loetlab-jena/xplorer/hw/xplorer_b.brd

## EAGLE design hw/xplorer_b.brd (2014-04-21)

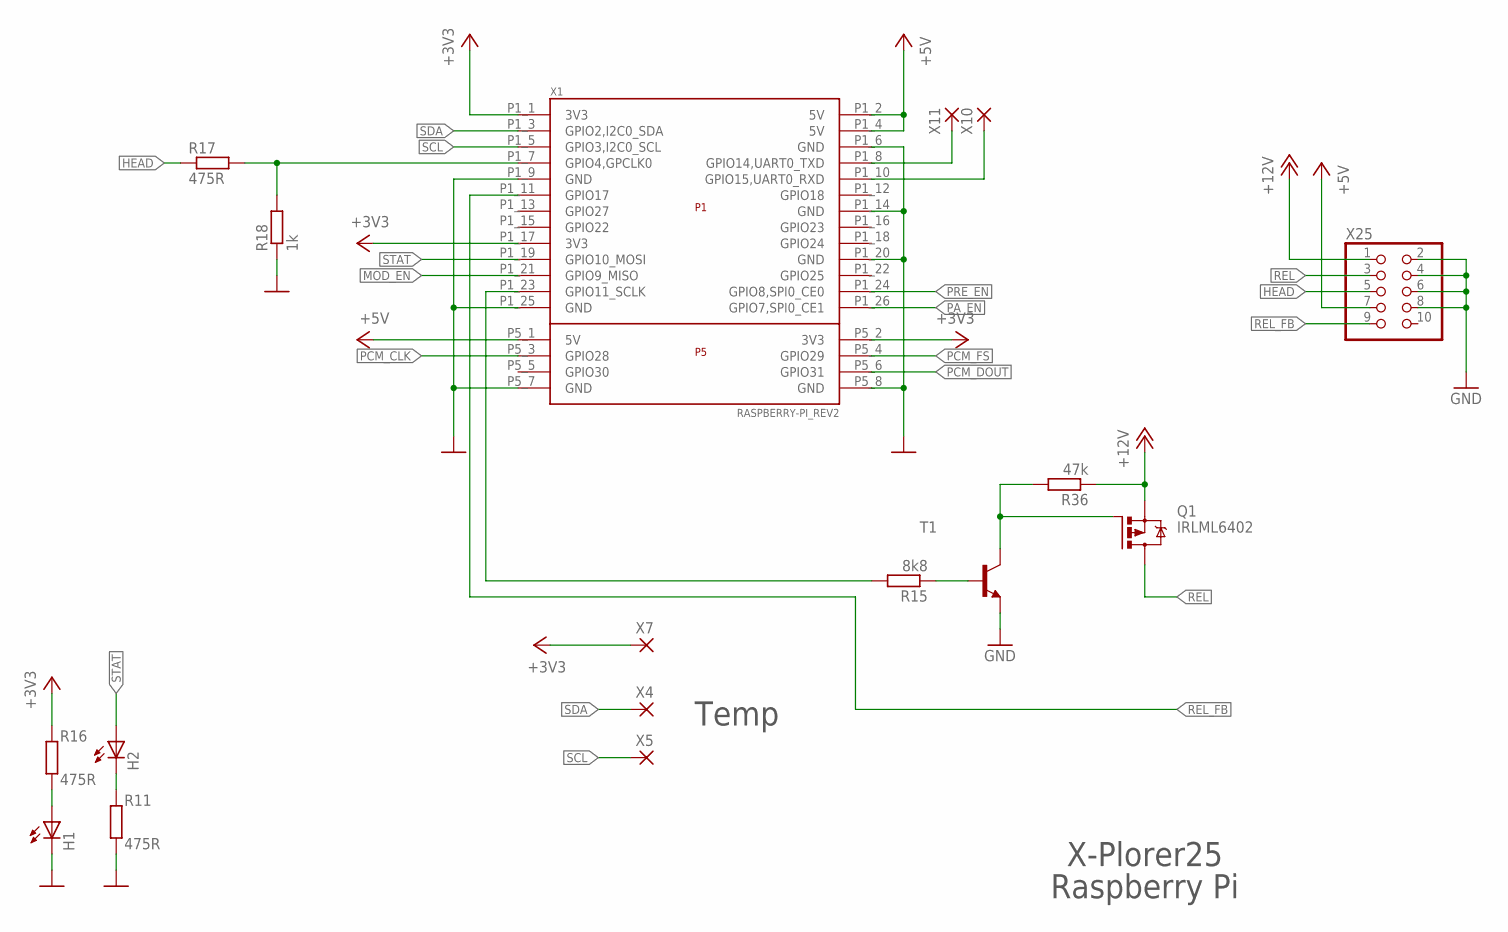
[picture p1: schematic xplorer_b.sch, sheet 1, RPI]

Parts:
H1, H2: PL006-WCR12; SOT23
Q1: IRLML6402; MICRO3
R11, R16, R17: 475R; R0603
R15: 8k8; R0603
R18: 1k; R0603
R36: 47k; R0603
T1: BC817-16-NPN-SOT23-BEC; SOT23-BEC
X1: RASPBERRY-PI_REV2
X4, X5, X7, X10, X11: SMD2; SMD1,27-2,54
X25: PINHD-2X5; 2X05

Connections:
+3V3: R16.2, X1.P1_1 (3V3), X1.P1_17 (3V3), X1.P5_2 (3V3), X7.1; also elsewhere on the board
+5V: X1.P1_2 (5V), X1.P1_4 (5V), X1.P5_1 (5V), X25.7; also elsewhere on the board
+12V: Q1.2 (S), R36.1, X25.1; also elsewhere on the board
GND: H1.3 (C), R11.1, R18.1, T1.E, X1.P1_6 (GND), X1.P1_9 (GND), X1.P1_14 (GND), X1.P1_20 (GND), X1.P1_25 (GND), X1.P5_7 (GND), X1.P5_8 (GND), X25.2, X25.4, X25.6, X25.8; also elsewhere on the board
HEAD: R17.1, X25.5
MOD_EN: X1.P1_21 (GPIO9_MISO); also elsewhere on the board
unnamed: H2.3 (C), R11.2
unnamed: H1.1 (A), R16.1
unnamed: R17.2, R18.2, X1.P1_7 (GPIO4,GPCLK0)
unnamed: X1.P1_10 (GPIO15,UART0_RXD), X10.1
unnamed: R15.1, T1.B
unnamed: Q1.1 (G), R36.2, T1.C
unnamed: X1.P1_8 (GPIO14,UART0_TXD), X11.1
unnamed: R15.2, X1.P1_23 (GPIO11_SCLK)
PA_EN: X1.P1_26 (GPIO7,SPI0_CE1); also elsewhere on the board
PCM_CLK: X1.P5_3 (GPIO28); also elsewhere on the board
PCM_DOUT: X1.P5_6 (GPIO31); also elsewhere on the board
PCM_FS: X1.P5_4 (GPIO29); also elsewhere on the board
PRE_EN: X1.P1_24 (GPIO8,SPI0_CE0); also elsewhere on the board
REL: Q1.3 (D), X25.3
REL_FB: X1.P1_11 (GPIO17), X25.9
SCL: X1.P1_5 (GPIO3,I2C0_SCL), X5.1; also elsewhere on the board
SDA: X1.P1_3 (GPIO2,I2C0_SDA), X4.1; also elsewhere on the board
STAT: H2.1 (A), X1.P1_19 (GPIO10_MOSI)

Notes on the sheet:
X-Plorer25
Raspberry Pi
Temp

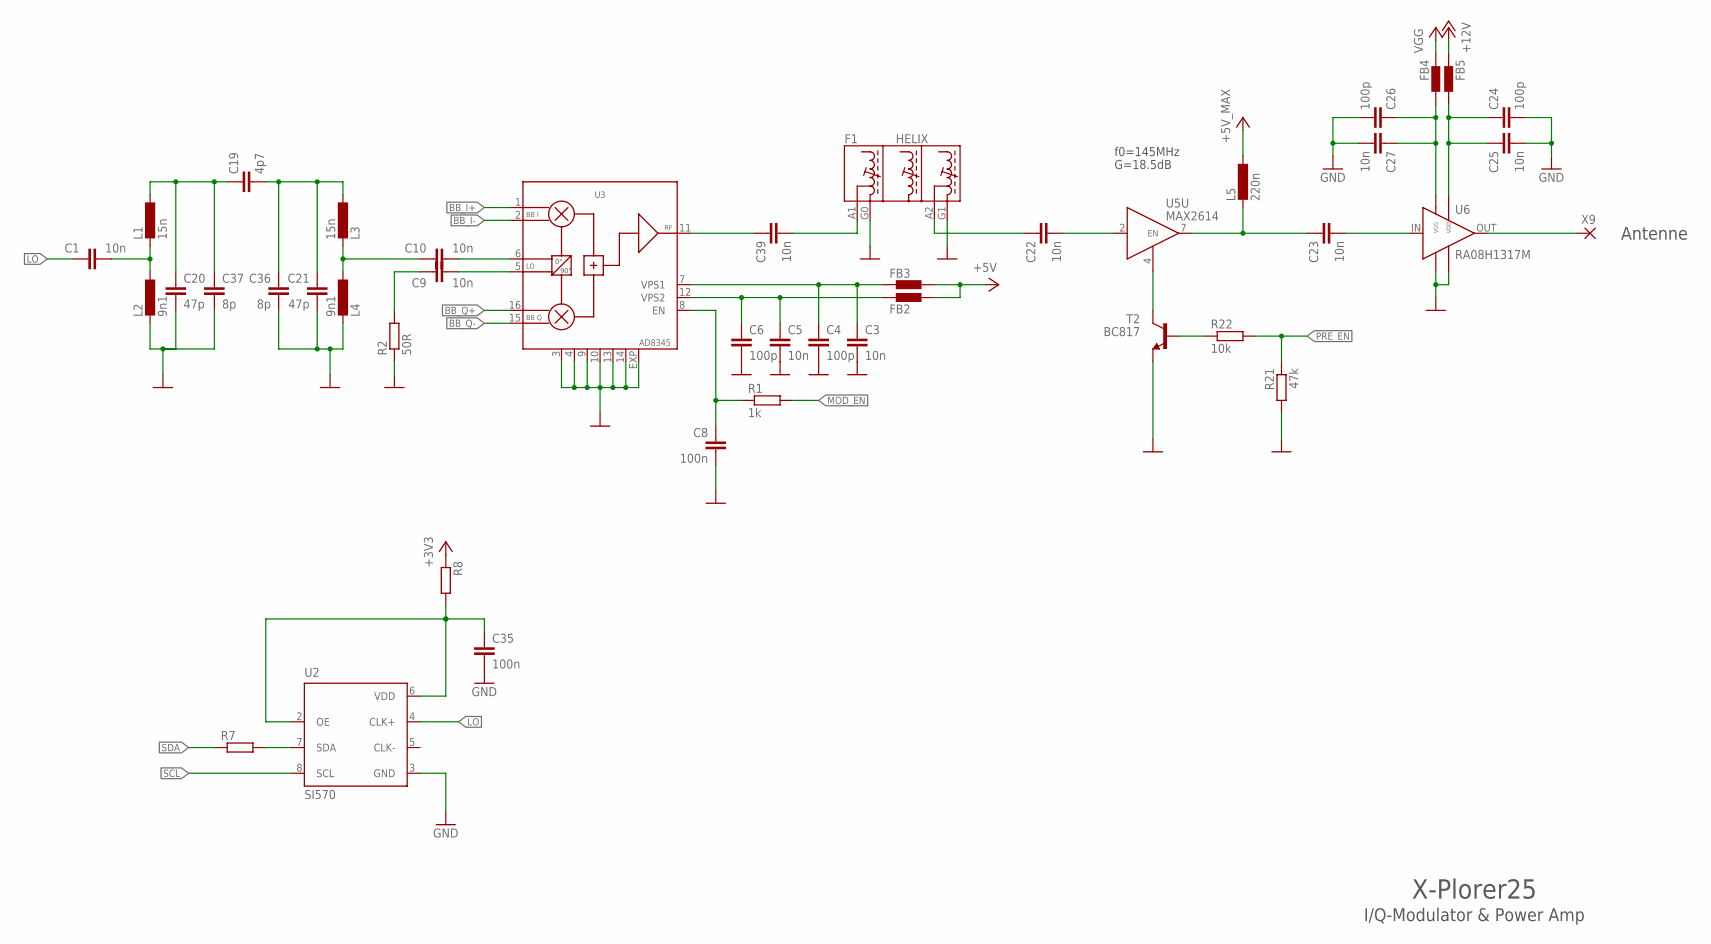
[picture p2: schematic xplorer_b.sch, sheet 2, IQ]

Parts:
C1, C3, C5, C9, C10, C22, C23, C25, C27, C39: 10n; C0603
C4, C6, C24, C26: 100p; C0603
C8: 100n; C0603
C19: 4p7; C0603
C20, C21: 47p; C0805K
C35: 100n; 0603
C36, C37: 8p; C0805K
F1: HELIX; CBT13
FB2, FB3, FB4, FB5: BML15H; R0603
L1, L3: 15n; L2012C
L2, L4: 9n1; L2012C
L5: 220n; L2012C
R1: 1k; R0603
R2: 50R; R0603
R7: R-EU_R0603; R0603
R8: R-EU_R2010; R2010
R21: 47k; R0603
R22: 10k; R0603
T2: BC817; SOT23-BEC
U2: SI570; 8-PIN
U3: AD8345; TSSOP16EXP
U5: MAX2614; TDFN8-2X3MM
U6: RA08H1317M
X9: SMD2; SMD1,27-2,54

Connections:
+3V3: R8.1; also elsewhere on the board
+5V: FB2.2, FB3.2; also elsewhere on the board
+5V_MAX: L5.1; also elsewhere on the board
+12V: FB5.1; also elsewhere on the board
BB_I+: U3.1 (BB_I); also elsewhere on the board
BB_I-: U3.2 (!BB_I); also elsewhere on the board
BB_Q+: U3.16 (BB_Q); also elsewhere on the board
BB_Q-: U3.15 (!BB_Q); also elsewhere on the board
CLEAN_LO: C10.1, L3.2, L4.1
GND: C3.2, C4.2, C5.2, C6.2, C8.2, C20.2, C21.2, C24.2, C25.2, C26.2, C27.2, C35.2, C36.2, C37.2, F1.G0 (GND), F1.G1 (GND), L2.2, L4.2, R2.1, R21.2, T2.E, U2.3 (GND), U3.3 (GND), U3.4 (GND), U3.9 (GND), U3.10 (GND), U3.13 (GND), U3.14 (GND), U3.EXP (GND), U6.G1 (GND), U6.G2 (GND); also elsewhere on the board
LO: C1.1, U2.4 (CLK+)
MOD_EN: R1.2; also elsewhere on the board
unnamed: C39.2, F1.A1
unnamed: C10.2, U3.6 (LO)
unnamed: C3.1, C4.1, FB3.1, U3.7 (VPS1)
unnamed: C5.1, C6.1, FB2.1, U3.12 (VPS2)
unnamed: C8.1, R1.1, U3.8 (EN)
unnamed: C9.2, U3.5 (!LO)
unnamed: C9.1, R2.2
unnamed: C39.1, U3.11 (RF)
unnamed: R7.2, U2.7 (SDA)
unnamed: C19.2, C21.1, C36.1, L3.1
unnamed: C22.1, F1.A2
unnamed: C1.2, L1.2, L2.1
unnamed: C35.1, R8.2, U2.2 (OE), U2.6 (VDD)
unnamed: C22.2, U5.2 (IN)
unnamed: C23.1, L5.2, U5.7 (OUT)
unnamed: C23.2, U6.IN
unnamed: C24.1, C25.1, FB5.2, U6.VDD
unnamed: C26.1, C27.1, FB4.2, U6.VGG
unnamed: U6.OUT, X9.1
unnamed: T2.C, U5.4 (EN)
unnamed: R22.1, T2.B
PRE_EN: R21.1, R22.2; also elsewhere on the board
SCL: U2.8 (SCL); also elsewhere on the board
SDA: R7.1; also elsewhere on the board
VGG: FB4.1; also elsewhere on the board
VLA: C19.1, C20.1, C37.1, L1.1

Notes on the sheet:
X-Plorer25
I/Q-Modulator & Power Amp
f0=145MHz
G=18.5dB
Antenne

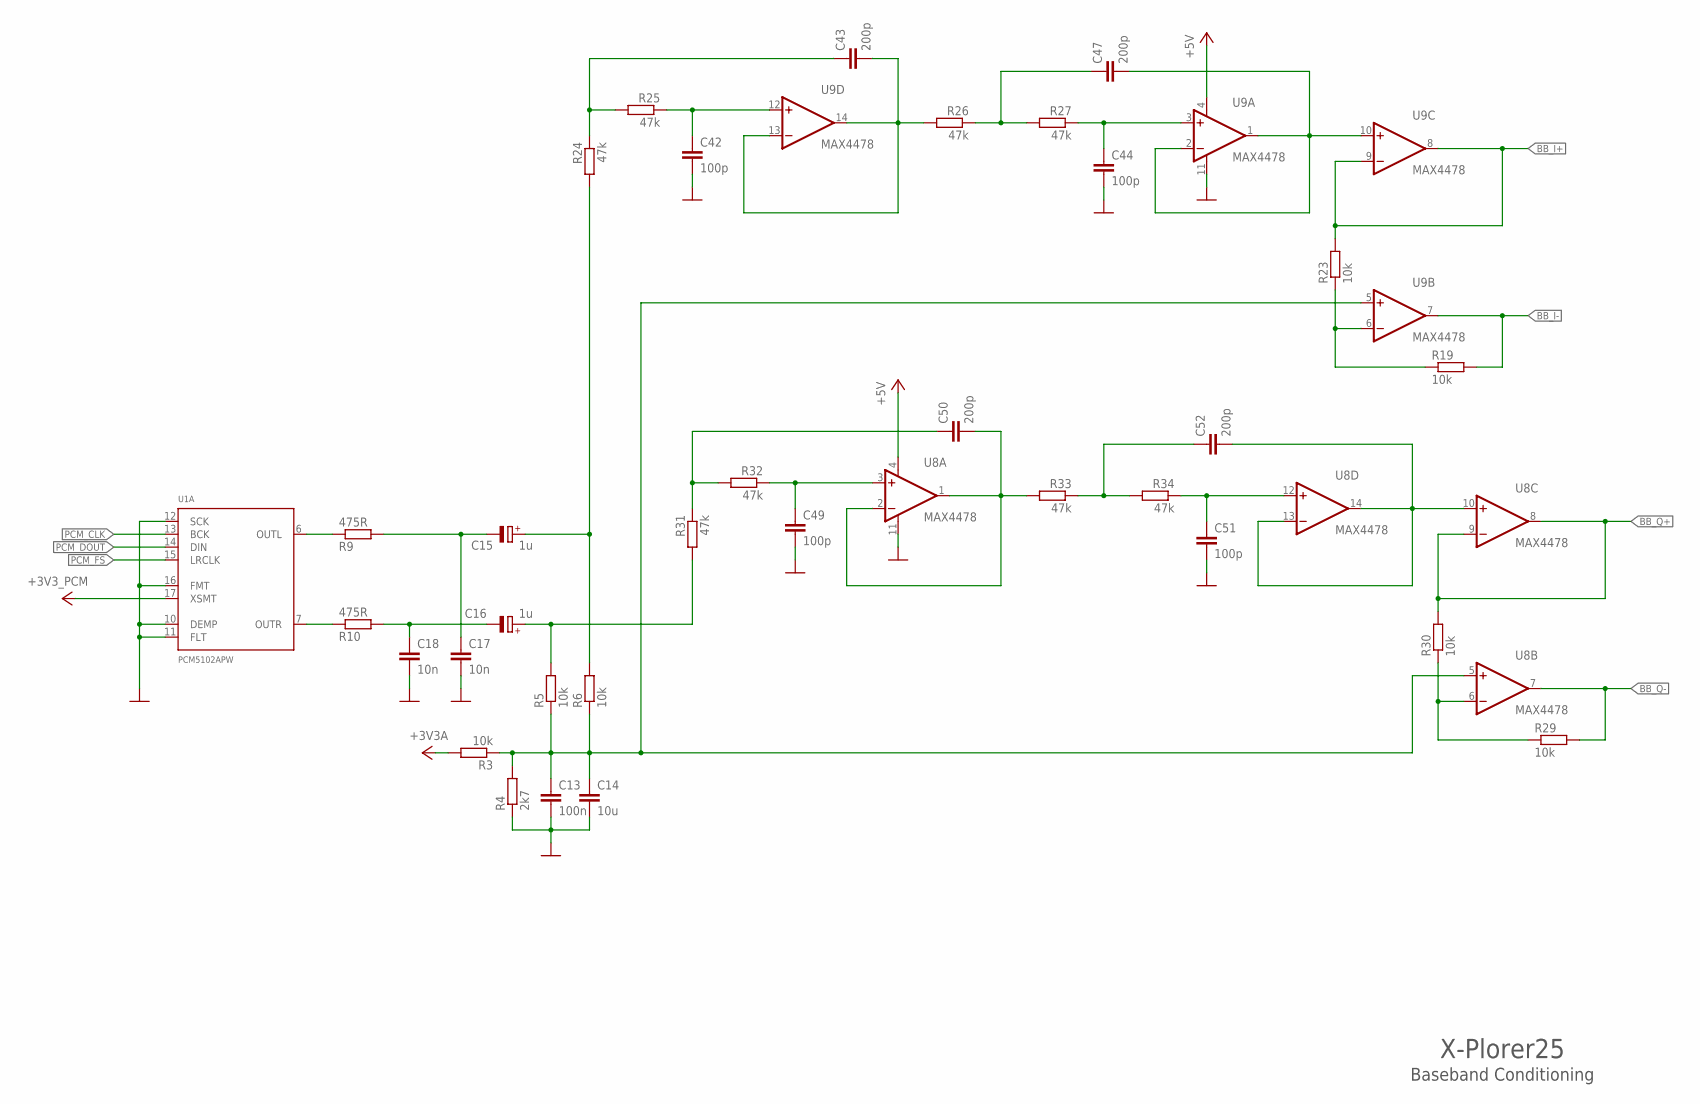
[picture p3: schematic xplorer_b.sch, sheet 3, BB]

Parts:
C13: 100n; C0603
C14: 10u; C0603
C15, C16: 1u; CT3528
C17, C18: 10n; C0603
C42, C44, C49, C51: 100p; C0603
C43, C47, C50, C52: 200p; C0805
R3, R5, R6, R19, R23, R29, R30: 10k; R0603
R4: 2k7; R0603
R9, R10: 475R; R0603
R24, R25, R26, R27, R31, R32, R33, R34: 47k; R0603
U1: PCM5102APW; PW_R-PDSO-G20
U8: MAX4478; SO14; MPN OPA4132UA
U9: MAX4478; SO14

Connections:
$2345: C16.+, R5.2, R31.2
$123456: C15.+, R6.2, R24.2
+3V3A: R3.2; also elsewhere on the board
+3V3_PCM: U1.17 (XSMT); also elsewhere on the board
+5V: U8.4 (V+), U9.4 (V+); also elsewhere on the board
BB_I+: R23.2, U9.8 (OUT), U9.9 (-IN); also elsewhere on the board
BB_I-: R19.2, U9.7 (OUT); also elsewhere on the board
BB_Q+: R30.2, U8.8 (OUT), U8.9 (-IN); also elsewhere on the board
BB_Q-: R29.2, U8.7 (OUT); also elsewhere on the board
GND: C13.2, C14.2, C17.2, C18.2, C42.2, C44.2, C49.2, C51.2, R4.1, U1.10 (DEMP), U1.11 (FLT), U1.12 (SCK), U1.16 (FMT), U8.11 (V-), U9.11 (V-); also elsewhere on the board
unnamed: C49.1, R32.1, U8.3 (+IN)
unnamed: R10.1, U1.7 (OUTR)
unnamed: C16.-, C18.1, R10.2
unnamed: R9.1, U1.6 (OUTL)
unnamed: C50.1, R31.1, R32.2
unnamed: C52.2, U8.10 (+IN), U8.13 (-IN), U8.14 (OUT)
unnamed: C51.1, R34.1, U8.12 (+IN)
unnamed: C52.1, R33.1, R34.2
unnamed: C42.1, R25.1, U9.12 (+IN)
unnamed: C43.1, R24.1, R25.2
unnamed: C47.2, U9.1 (OUT), U9.2 (-IN), U9.10 (+IN)
unnamed: C44.1, R27.1, U9.3 (+IN)
unnamed: C47.1, R26.1, R27.2
unnamed: C43.2, R26.2, U9.13 (-IN), U9.14 (OUT)
unnamed: C50.2, R33.2, U8.1 (OUT), U8.2 (-IN)
unnamed: R19.1, R23.1, U9.6 (-IN)
unnamed: R29.1, R30.1, U8.6 (-IN)
unnamed: C15.-, C17.1, R9.2
PCM_CLK: U1.13 (BCK); also elsewhere on the board
PCM_DOUT: U1.14 (DIN); also elsewhere on the board
PCM_FS: U1.15 (LRCLK); also elsewhere on the board
VGND: C13.1, C14.1, R3.1, R4.2, R5.1, R6.1, U8.5 (+IN), U9.5 (+IN)

Notes on the sheet:
X-Plorer25
Baseband Conditioning

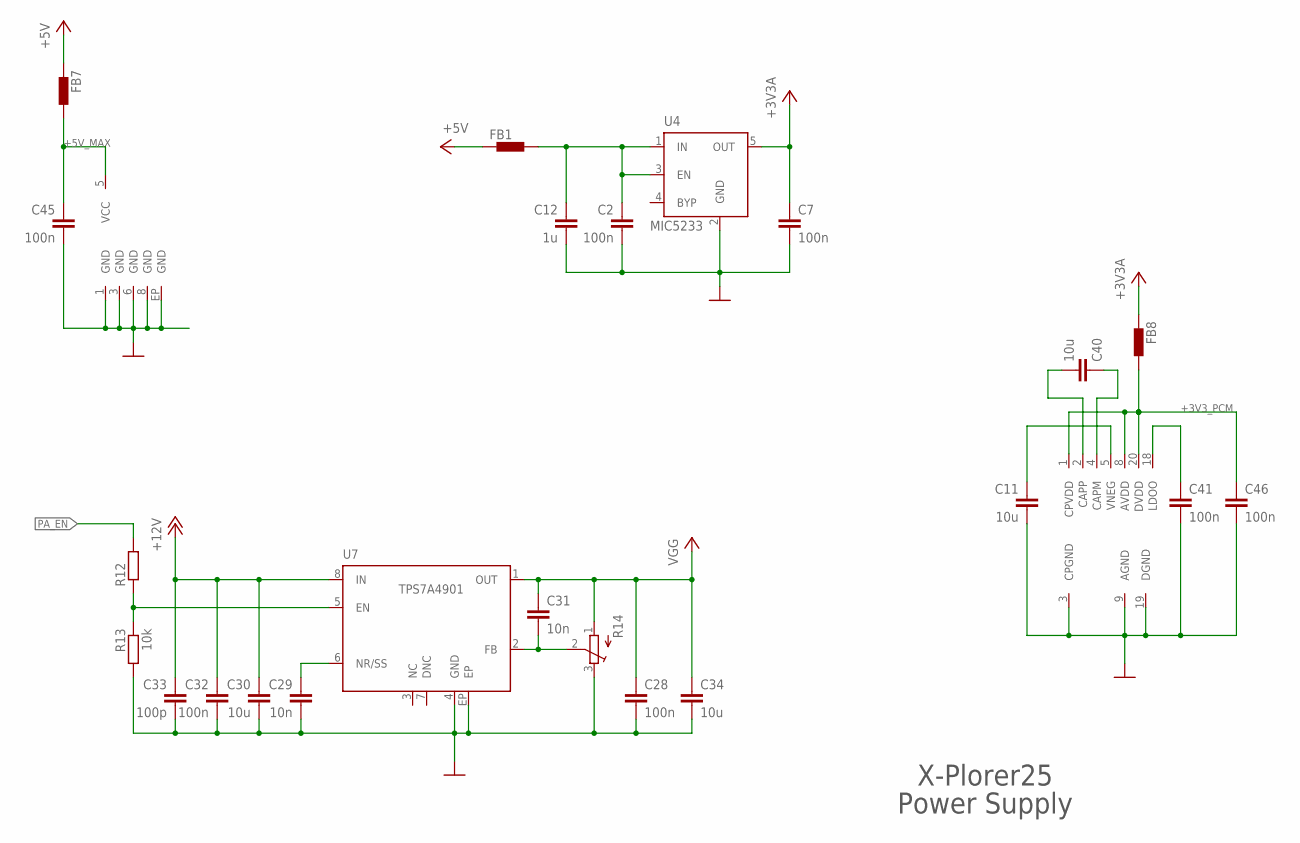
[picture p4: schematic xplorer_b.sch, sheet 4, PWR]

Parts:
C2, C7, C28, C32, C41, C45, C46: 100n; C0603
C11, C30, C34, C40: 10u; C0805
C12: 1u; C0603
C29: 10n; C0603K
C31: 10n; C0603
C33: 100p; C0603
FB1, FB7, FB8: BML15H; R0603
R12: R-EU_R0603; R0603
R13: 10k; R0603
R14: TRIM_EU-SM-42/43X; SM-42/43X
U1: PCM5102APW; PW_R-PDSO-G20
U4: MIC5233; SOT23-5
U5: MAX2614; TDFN8-2X3MM
U7: TPS7A4901; PW_R-PDSO-G08

Connections:
12V_F: C2.1, C12.1, FB1.2, U4.1 (IN), U4.3 (EN)
+3V3A: C7.1, FB8.1, U4.5 (OUT); also elsewhere on the board
+3V3_PCM: C46.1, FB8.2, U1.1 (CPVDD), U1.8 (AVDD), U1.20 (DVDD); also elsewhere on the board
+5V: FB1.1, FB7.1; also elsewhere on the board
+5V_MAX: C45.1, FB7.2, U5.5 (VCC); also elsewhere on the board
+12V: C30.1, C32.1, C33.1, U7.8 (IN); also elsewhere on the board
GND: C2.2, C7.2, C11.2, C12.2, C28.2, C29.2, C30.2, C32.2, C33.2, C34.2, C41.2, C45.2, C46.2, R13.2, R14.3 (E), U1.3 (CPGND), U1.9 (AGND), U1.19 (DGND), U4.2 (GND), U5.1 (GND), U5.3 (GND), U5.6 (GND), U5.8 (GND), U5.EP (GND), U7.4 (GND), U7.EP; also elsewhere on the board
unnamed: R12.1, R13.1, U7.5 (EN)
unnamed: C31.2, R14.2 (S), U7.2 (FB)
unnamed: C11.1, U1.5 (VNEG)
unnamed: C40.1, U1.4 (CAPM)
unnamed: C40.2, U1.2 (CAPP)
unnamed: C41.1, U1.18 (LDOO)
unnamed: C29.1, U7.6 (NR/SS)
PA_EN: R12.2; also elsewhere on the board
VGG: C28.1, C31.1, C34.1, R14.1 (A), U7.1 (OUT); also elsewhere on the board

Notes on the sheet:
X-Plorer25
Power Supply

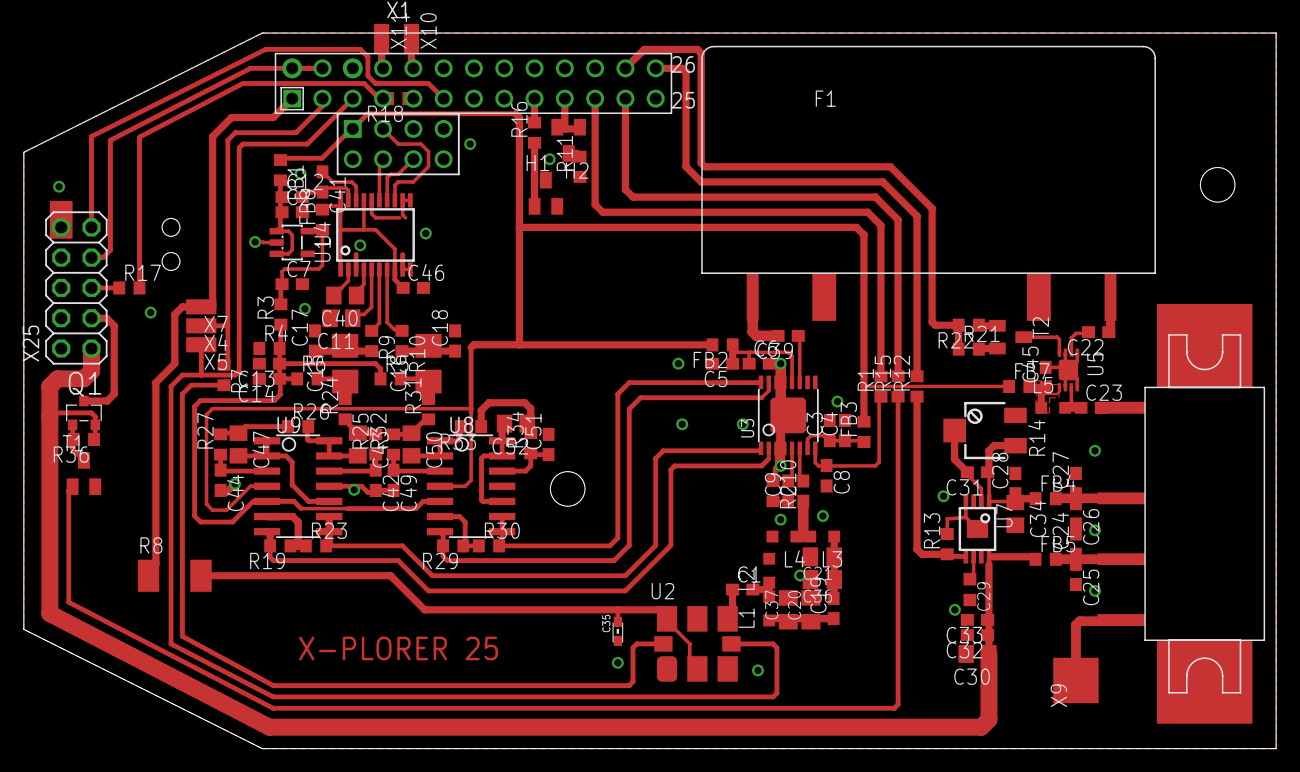
[picture p5: board xplorer_b.brd from above]

Board: 2 copper layers, 105.0 x 60.0 mm, 118 parts (0 on the bottom side), 85 nets.
