loetlab-jena/xplorer/hw/xplorer_t.brd

## EAGLE design hw/xplorer_t.brd (2014-04-24)

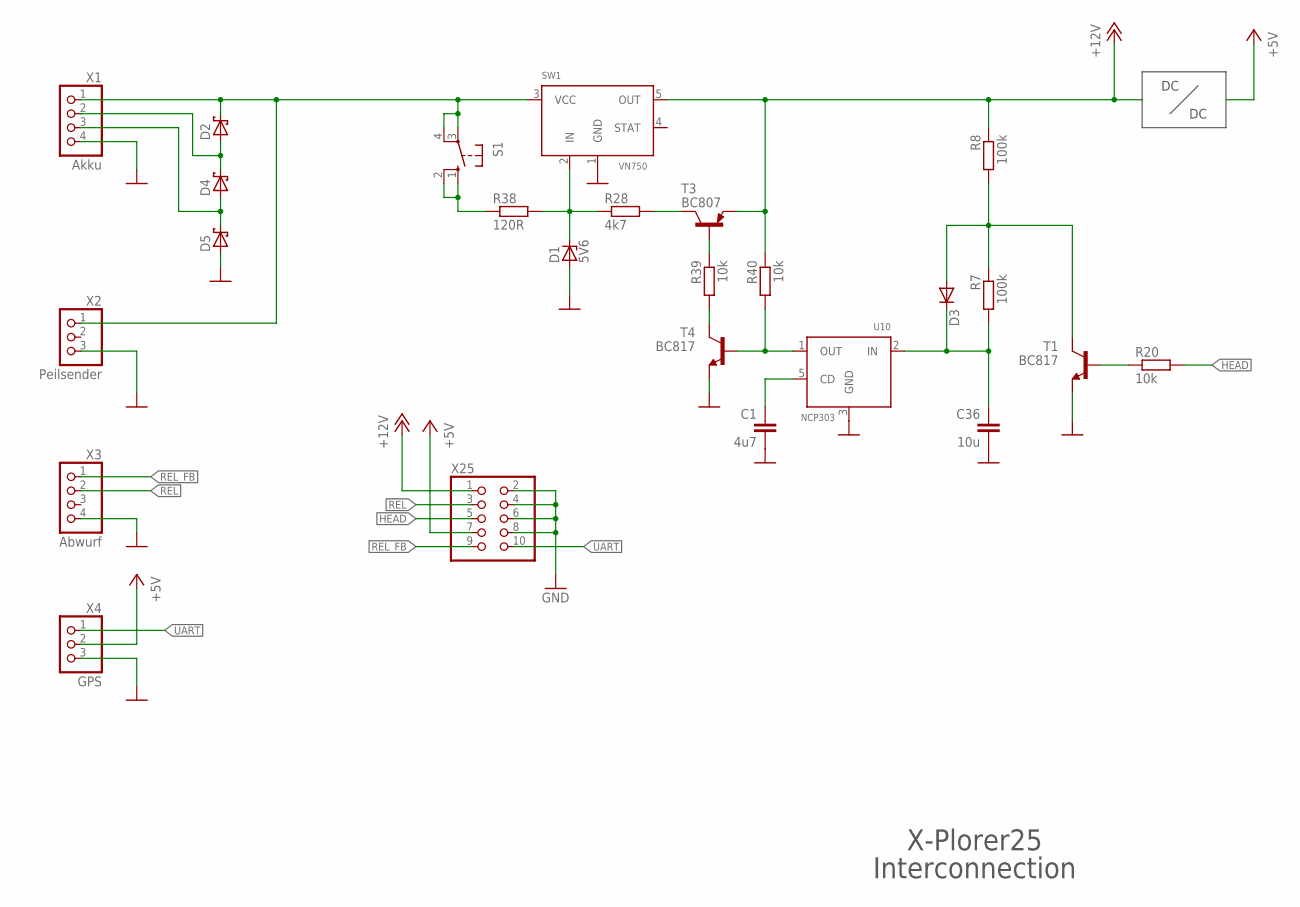
[picture p6: schematic xplorer_t.sch, RPI]

Parts:
C1: 4u7; C1210
C36: 10u; C1210
D1: 5V6; SOT23
D2, D4, D5: MBRS130LT3; SMB
D3: DIODE-MINIMELF; MINIMELF
R7, R8: 100k; R0805
R20, R39, R40: 10k; R0805
R28: 4k7; R0805
R38: 120R; R1206
S1: 10-XX; B3F-10XX
SW1: VN750; DDPAK
T1, T4: BC817; SOT23-BEC
T3: BC807; SOT23-BEC
U10: NCP303; SOT23-DBV
X1: Akku; 1X04
X2: Peilsender; 1X03/90
X3: Abwurf; 1X04/90
X4: GPS; 1X03
X25: PINHD-2X5; 2X05

Connections:
+5V: X4.2, X25.7
+12V: R8.1, R40.1, SW1.5 (OUT), T3.E, X25.1
GND: C1.2, C36.2, D1.1 (A), D5.A, SW1.1 (GND), T1.E, T4.E, U10.3 (GND), X1.4, X2.3, X3.4, X4.3, X25.2, X25.4, X25.6, X25.8
HEAD: R20.2, X25.5
unnamed: C1.1, U10.5 (CD)
unnamed: D2.A, D4.C, X1.2
unnamed: D4.A, D5.C, X1.3
unnamed: R38.1, S1.1 (S), S1.2 (S1)
unnamed: C36.1, D3.C, R7.2, U10.2 (IN)
unnamed: D2.C, S1.3, S1.4 (P1), SW1.3 (VCC), X1.1, X2.1
unnamed: D1.3 (C), R28.1, R38.2, SW1.2 (IN)
unnamed: D3.A, R7.1, R8.2, T1.C
unnamed: R28.2, T3.C
unnamed: R20.1, T1.B
unnamed: R39.2, T4.C
unnamed: R39.1, T3.B
unnamed: R40.2, T4.B, U10.1 (OUT)
REL: X3.2, X25.3
REL_FB: X3.1, X25.9
UART: X4.1, X25.10

Notes on the sheet:
X-Plorer25
Interconnection

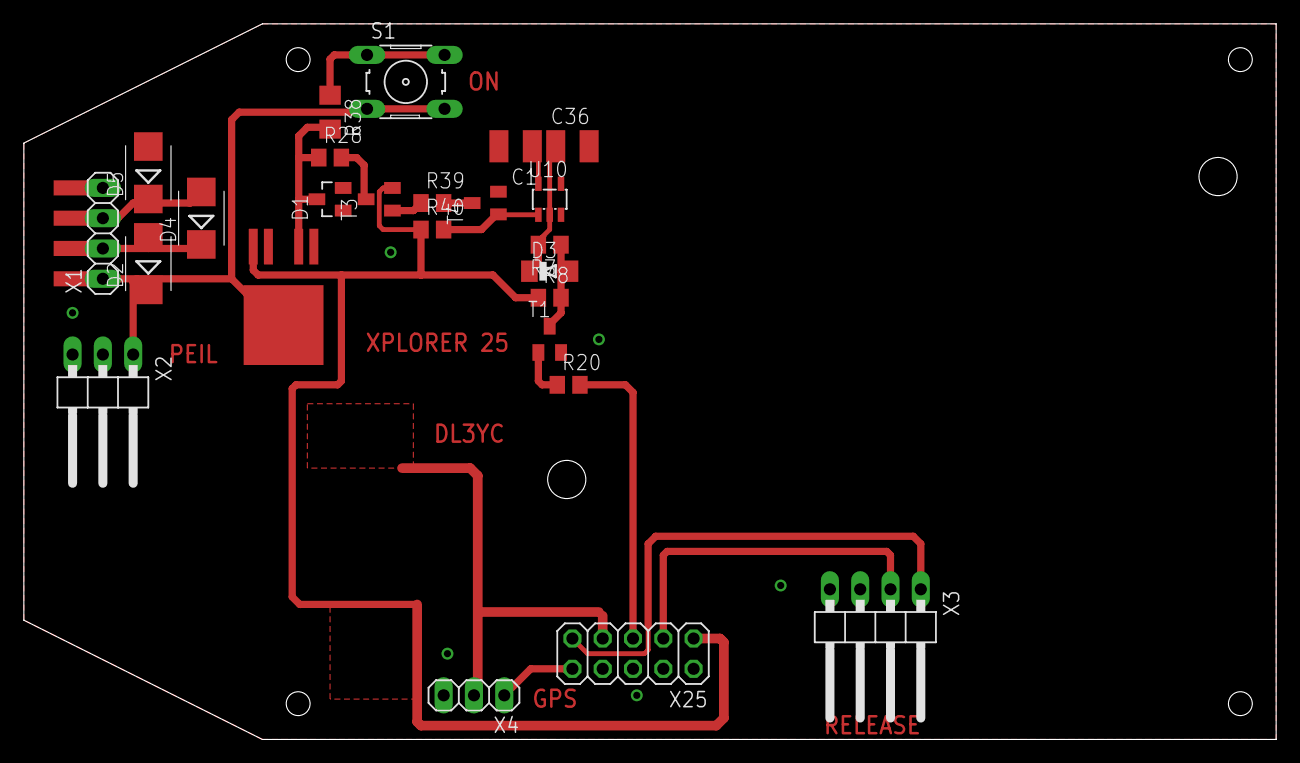
[picture p7: board xplorer_t.brd from above]

Board: 2 copper layers, 105.0 x 60.0 mm, 25 parts (0 on the bottom side), 20 nets.
