loetlab-jena/xplorer/rfmod.py

#!/usr/bin/env python
#
# python wrapper for modulation and encoding methods

import os
import afskencoder
import logging

gain = 0.1

def fmmod(in_fname, out_fname, fc):
	# call fmmod with its parameters
	# parameters for I,Q-gain and phase are determined by experimentation
	os.system('./fmmod %s %s 15000 3000 0.11 0.1095 87.5' % (in_fname, out_fname))
	pass

def aprs(lat, lon, alt):
	# no LO offset needed
	try:
		afskencoder.build_packet(str(lat), str(lon), str(alt), 'aprs_enc.wav')
	except Exception:
		logging.warn("RF could not convert GPS coords to string (no fix?)")
		pass
	os.system('rm aprs_resamp.wav')
	os.system('resample -to 48000 aprs_enc.wav aprs_resamp.wav')
	fmmod('aprs_resamp.wav', 'aprs_fmmod.wav', 0)
	pass

def sstv(in_fname, out_fname):
	# no LO offset needed
	os.system('convert %s -resize 320x240 sstv.jpg' % in_fname)
	os.system('./robot36 sstv.jpg sstv_enc.wav')
	os.system('rm sstv_resamp.wav')
	os.system('resample -to 48000 sstv_enc.wav sstv_resamp.wav')
	fmmod('sstv_resamp.wav', out_fname, 0)
	pass
