loetlab-jena/xplorer/(commit log)

2014-02-17 fix compile error in fmmod
    addition of the gain-parameter lead to a build failure
    [fmmod.c]
2014-02-21 error handling of samplerate(nyquist criterion)
    show error when carrier + freqdev >= samplerate/2
    [fmmod.c]
2014-02-21 error handling of freqdev
    show error when frequency deviation is negative
    [fmmod.c]
2014-02-21 Typo in error message
    [fmmod.c]
2014-02-21 add the python AFSK encoder
    this commit adds the python implementation. it is heavily commented for
    review. has to be recoded in C and highly optimised to be efficient on
    board.
2014-02-21 bugfix on gain and phase parameters
    [fmmod.c]
2014-02-22 argument check fix in fmmod
    this fixes the argument range check. it was not possible to include a
    phase offset
    [fmmod.c]
2014-02-23 introduce the mission control framework
    adds mission-control and the transmitter module. the transmitter module
    presents a workqueue to the system, handling all the RF lifting
    (frequency setup, enabling/disabling of the PA, I/Q audio playing, etc)
    the missionctl ATM only represents a test utility for transmitter, but
    will in the future implement the actual mission schedule
2014-02-23 introduce python logging framework
    this replaces the "print"-orgys by using the logging feature of python.
    also, adds TODO in the transmitter
    [missionctl.py, transmitter.py]
2014-02-23 intendation fix in log output
    simple one-line fix for bad intendation
    [missionctl.py]
2014-02-23 add gps listener, switch to python2.7
    this commit adds the GPS listener and switches everything back to
    python2.7, which is no big drawback. it's just because the
    GPSd-python-bindings are not available under python3
    [gpslistener.py, missionctl.py, transmitter.py]
2014-02-24 fix freqdev parameter error
    freqdev was only set if it was the last argument given. this was not
    intended.
    [fmmod.c]
2014-02-24 add raspberry-pi relevant parts
    this adds functionality for running on the raspberry pi. it
    conditionally includes the GPIO module and opts out all GPIO commands if
    we're not running on raspberry pi.
    also removes some old code, and waits for the gps-listener to have a fix
    [gpslistener.py, missionctl.py, transmitter.py]
2014-02-25 add gpio dummy handlers
    when not running on a raspberry pi, the GPIO accesses are opted out and
    only used as debugging messages in the log.
2014-02-25 opt out /dev/mem from loctl when not on arm
2014-02-25 add hfmod module and implement mission flow
    this adds a dummy module that will handle the actual modulation and
    encoding for aprs and sstv, also fmmod.
    it also includes the flow that will be in the mission, including
    parameters for mission time.
    some things still need to be done, they are marked with TODO
2014-02-26 bugfix for loop delays
    [missionctl.py]
2014-02-27 add logfile deletion to clean-target
    fix runtime errors because of rfmod-rename
    [missionctl.py]
2014-02-27 add runtime error because of wrong parameters
    [rfmod.py]
2014-02-27 change pin numbers for LEDs
2014-02-27 fix typo in GPIO module
    [missionctl.py]
2014-02-27 fixes #1 from mission test
    [missionctl.py]
2014-03-14 fixes for next software test
    [afskencoder.py, gpio_dummy.py, gpslistener.py, rfmod.py]
2014-03-14 implement release, correct LO-offsets, deactivation of RF
    [gpio_dummy.py, missionctl.py, rfmod.py, transmitter.py]
2014-03-20 add pcb files
    [xplorer.brd, xplorer.sch]
2014-03-20 include correct GPIO numbers for payload, handle rf on and off
    [missionctl.py, transmitter.py]
2014-03-20 update sound files, fmmod 0 hz offset
2014-03-20 correct release pin numbers
    [missionctl.py]
2014-03-20 fix output mode setting in transmitter
    [transmitter.py]
2014-03-20 equalize audio files, 300Hz-3,5kHz
2014-03-20 switch LO on/off, correct queueing of numbers
    [missionctl.py, transmitter.py]
2014-04-17 add remaining fixes for productive tests
    [missionctl.py]
2014-04-19 add i2c depencies to installation manual
2014-04-19 handle i2c slave not present error in loctl570
    [loctl570.c]
2014-04-20 use the correct packet file, correct si570 offset (5kHz)
    [rfmod.py, transmitter.py]
2014-04-20 fix format error in APRS packet
    [missionctl.py]
2014-04-20 finally fix APRS data format
    [missionctl.py]
2014-04-20 switch frequencies 144.800/145.200
2014-04-21 rev2 of rf board
    [RF-PCB.brd, RF-PCB.sch]
2014-04-21 correct pcb file structure
    [RF-PCB.brd, RF-PCB.sch, xplorer.brd, xplorer.sch]
2014-04-24 add board files of upper pcb with headshot, switching supply and connectors
    [xplorer_b.brd, xplorer_b.sch, xplorer_t.brd, xplorer_t.sch]
2014-05-02 add cron file for camera images
2014-05-02 fix callsign and symbol in APRS
    [afskencoder.py]
2014-05-02 fix the hack, typo
    [transmitter.py]
2014-05-03 improve error handling
    we found crashed with the new GPS mouse, seemingly because GPSd provides
    different values than with the HOLUX mouse when there is no fix
    available
    [afskencoder.py, missionctl.py, rfmod.py, transmitter.py]
2014-05-05 fix error in debug output
    [missionctl.py]
2014-05-06 handle timeout for raspistill, log timeout error
    [missionctl.py]
